r2aiv/motor_driver/IMG-20170615-WA0000.jpg

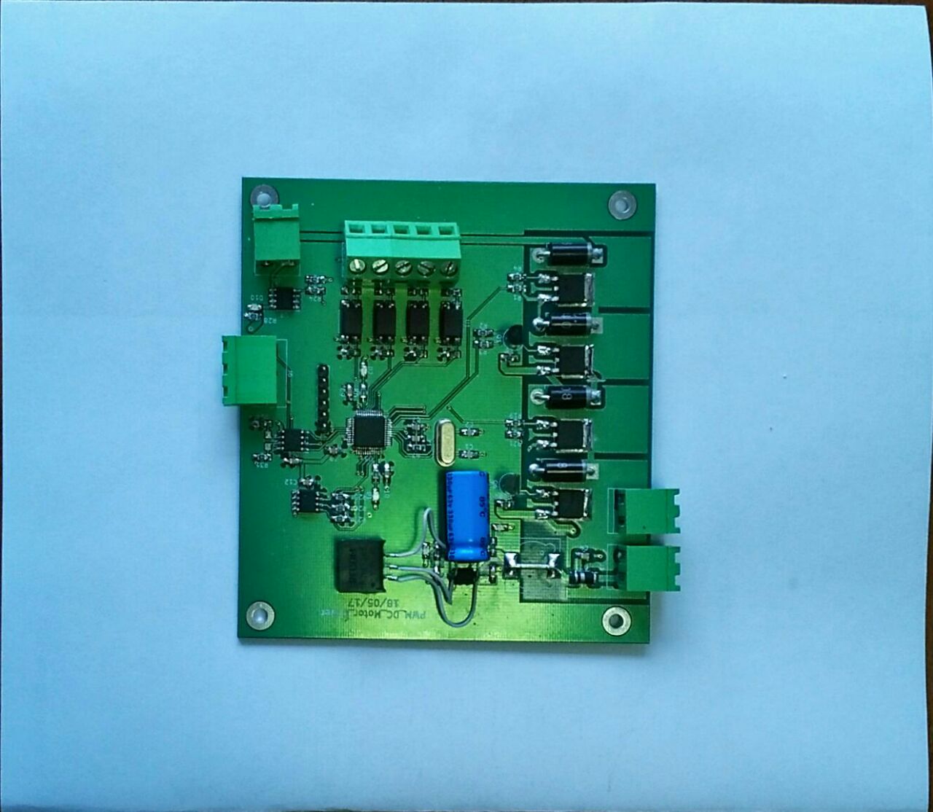
IMG-20170615-WA0000.jpg
