r2aiv/motor_driver/schematic.pdf

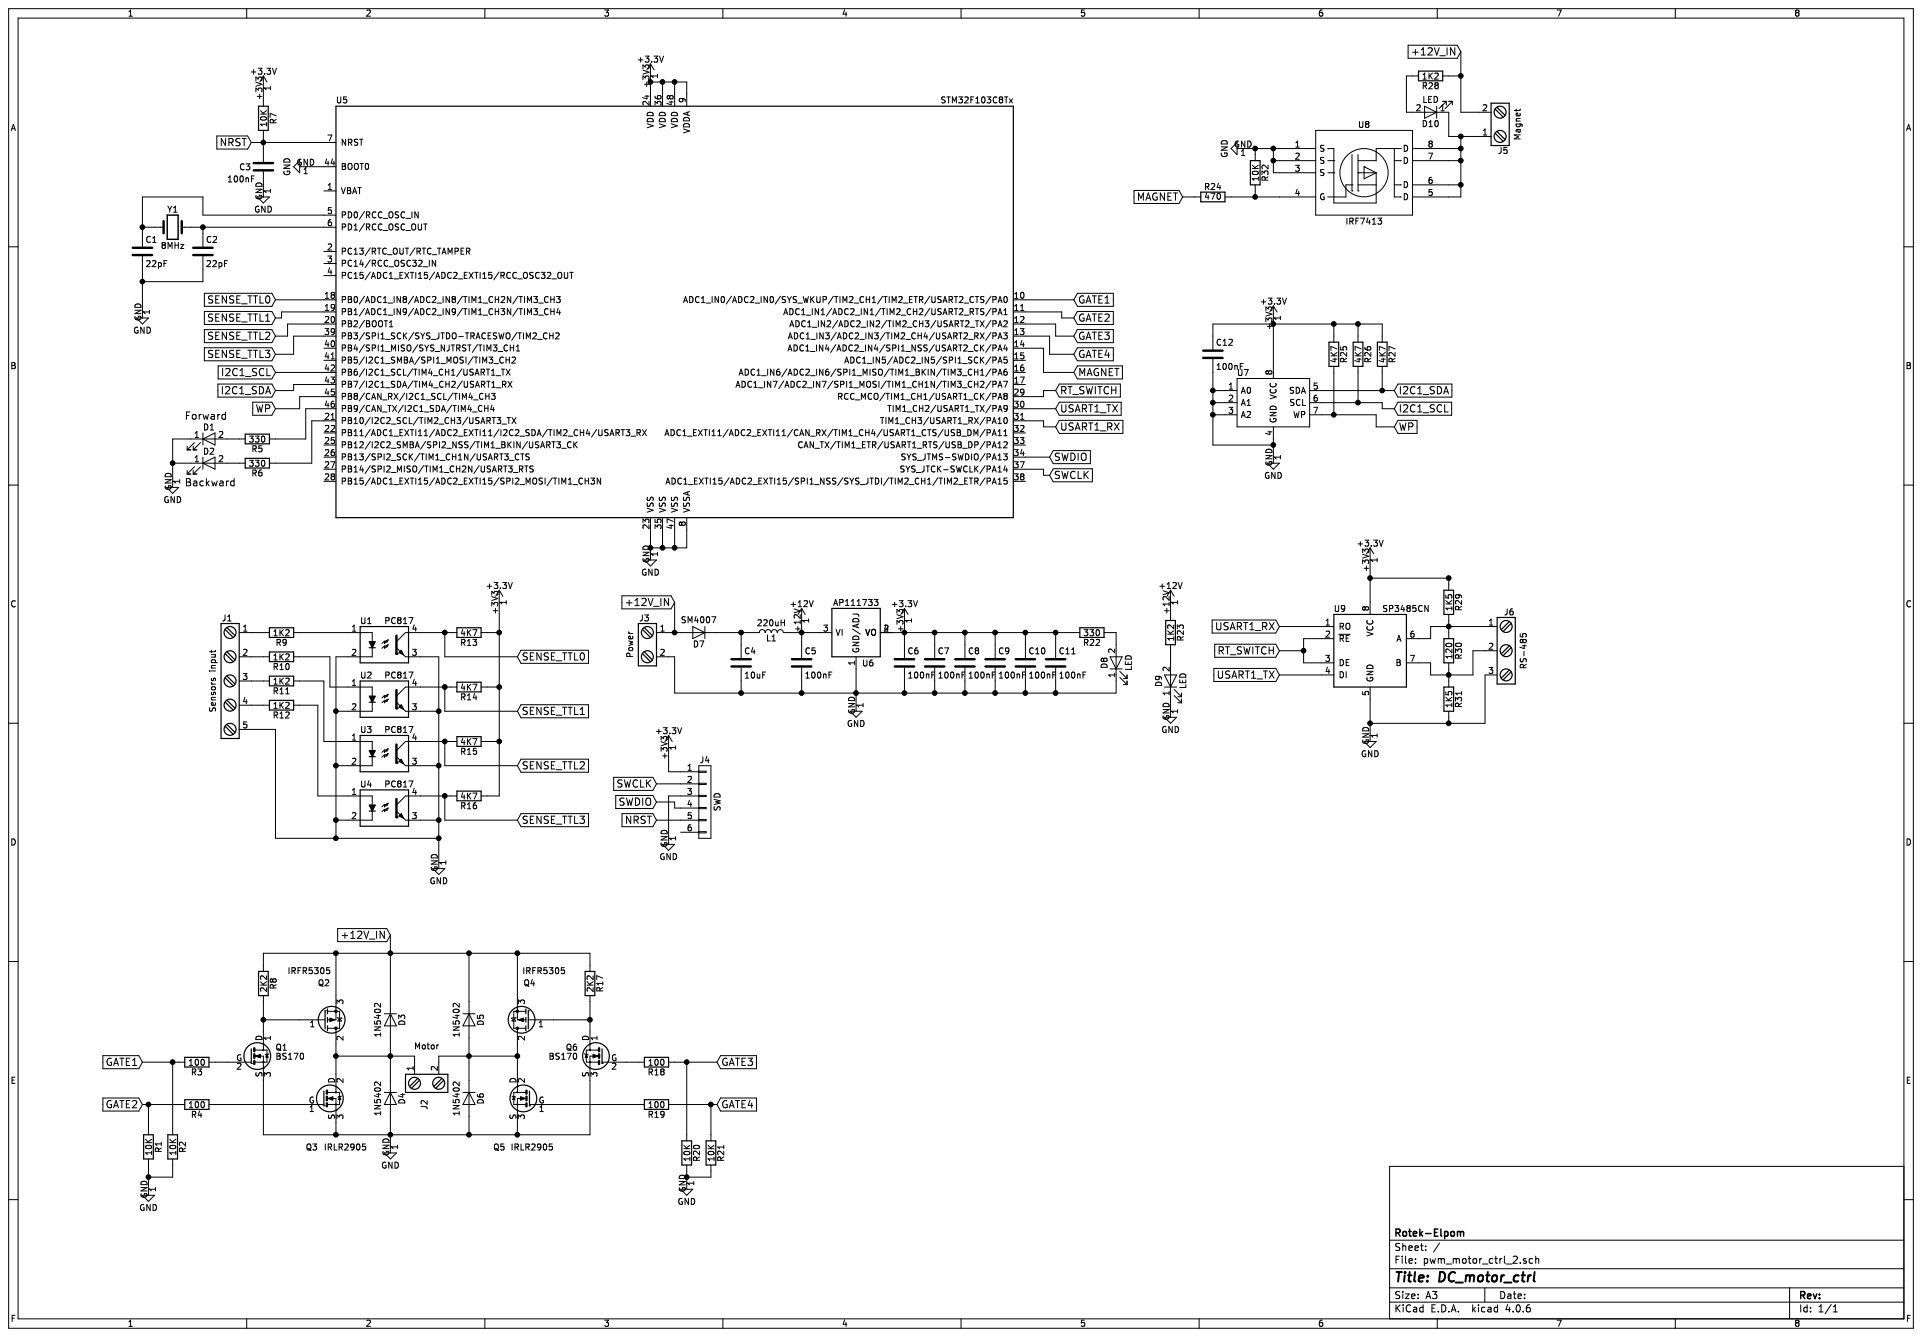
[picture p2: page 1]
