r2aiv/motor_driver/bot.pdf

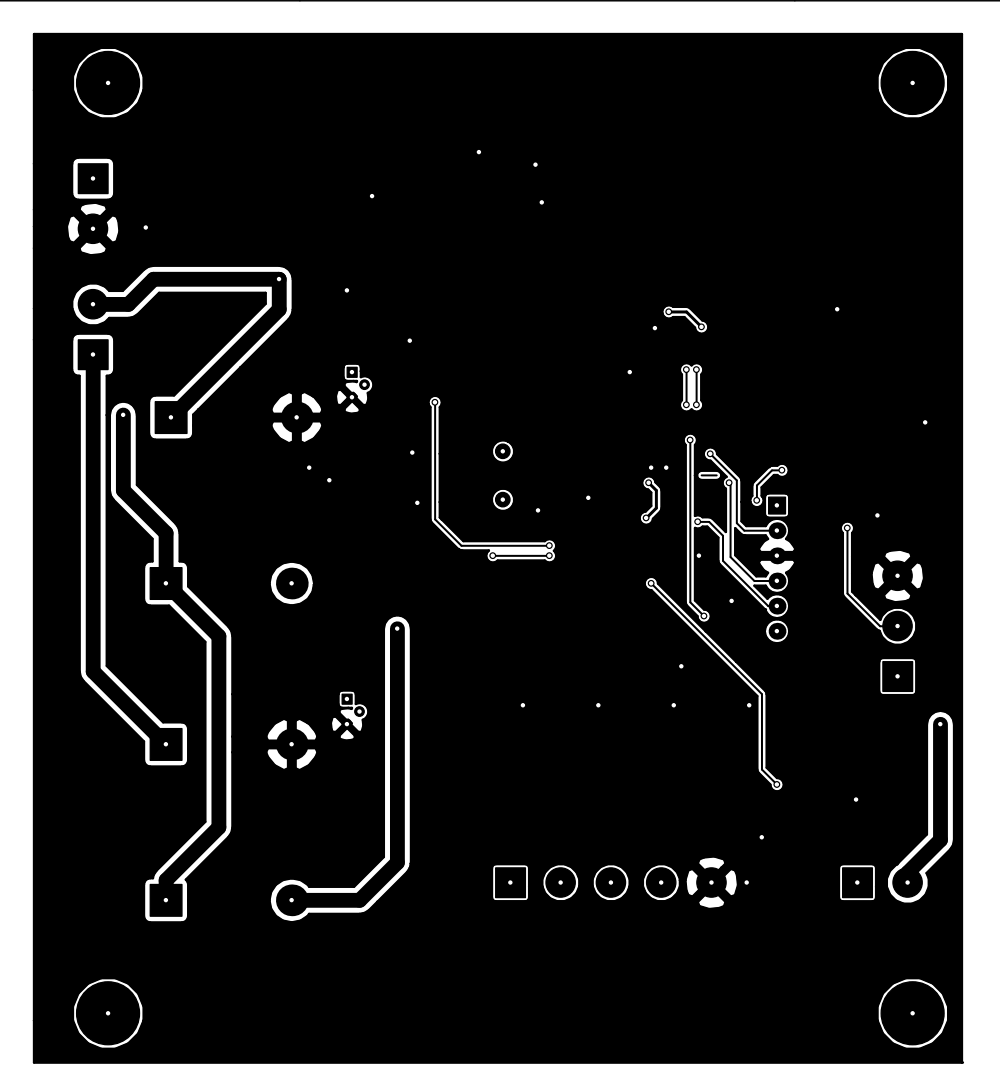
[picture p3: page 1]
