r2aiv/motor_driver/top.pdf

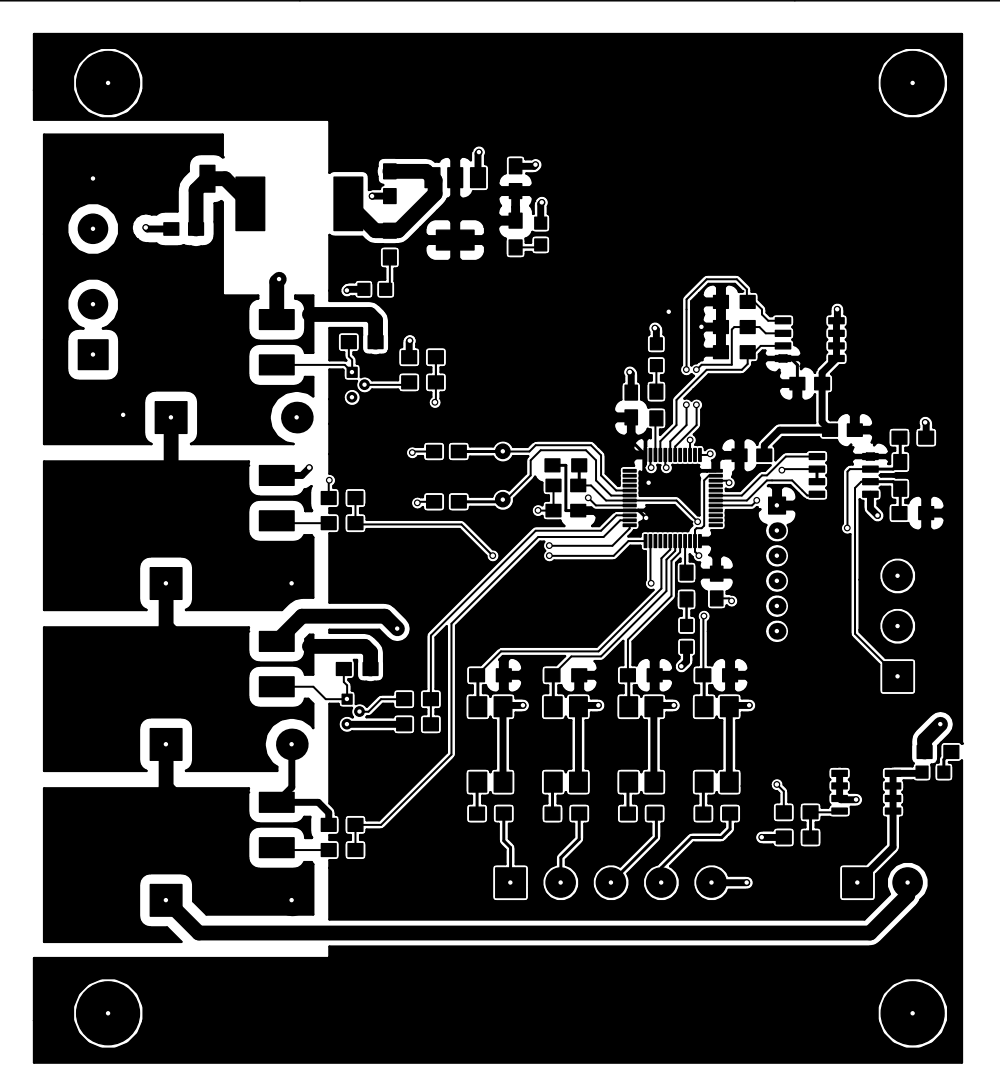
[picture p4: page 1]
