r2aiv/motor_driver/Сборка.pdf

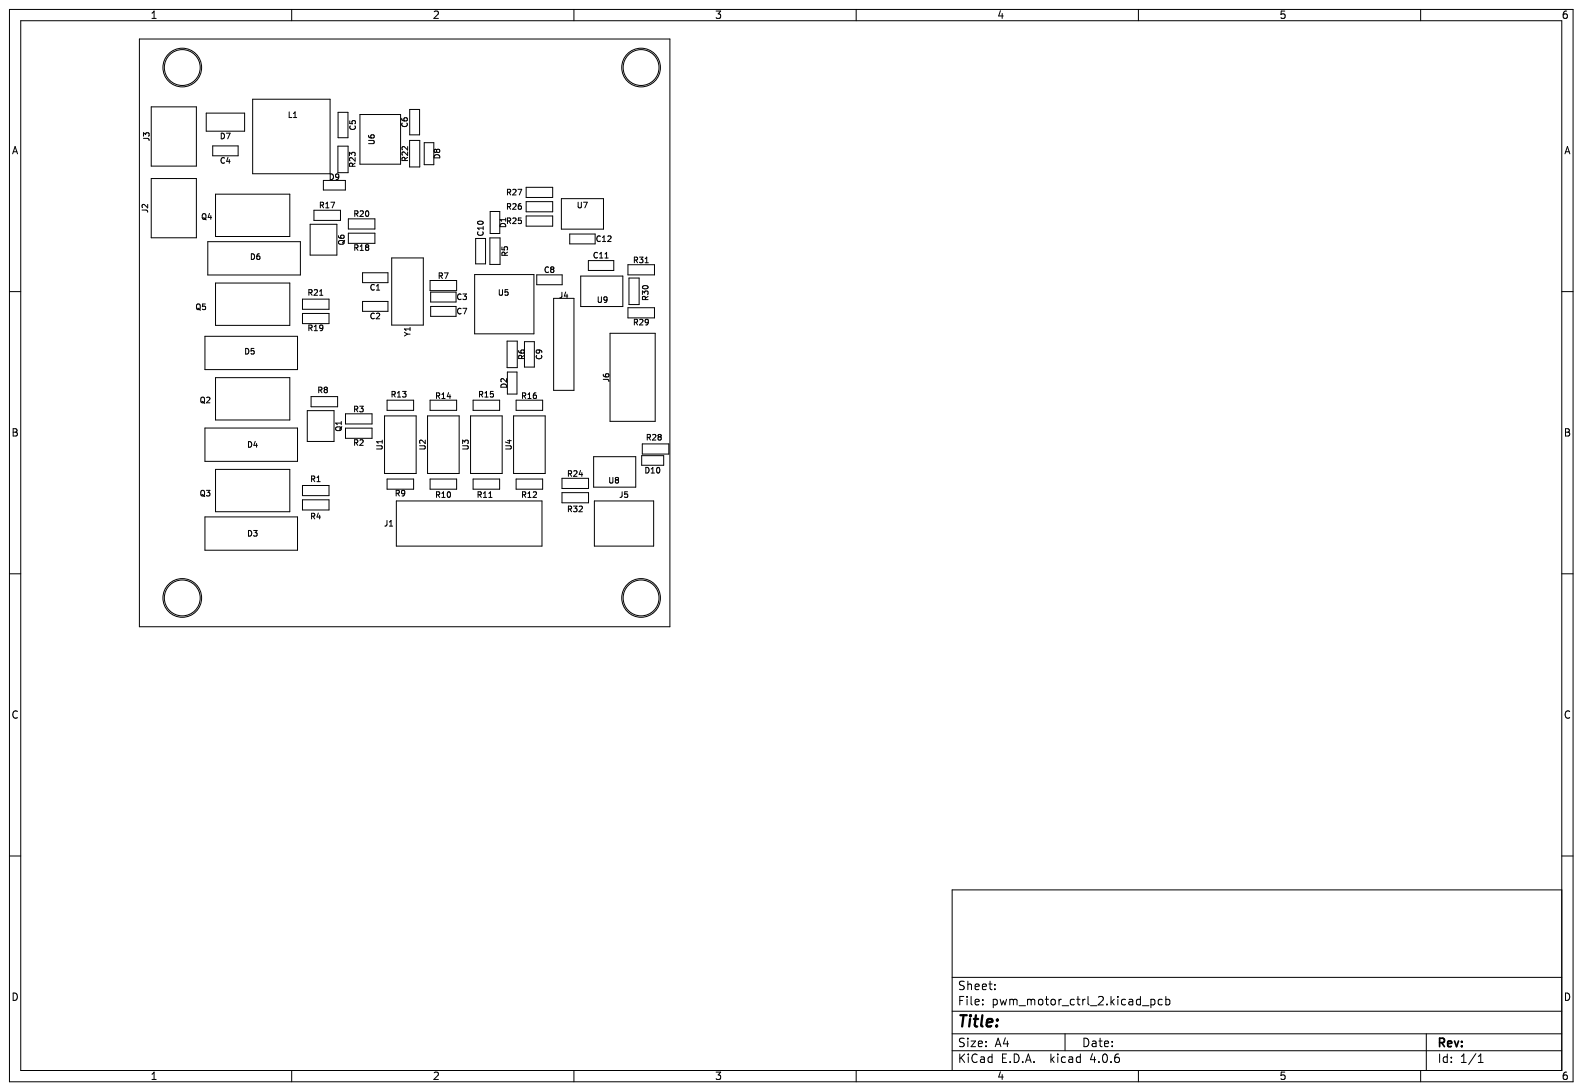
[picture p5: page 1]
