r2aiv/motor_driver/pwm_motor_ctrl_2.kicad_pcb

## KiCad design pwm_motor_ctrl_2.kicad_pcb (2017-08-29)

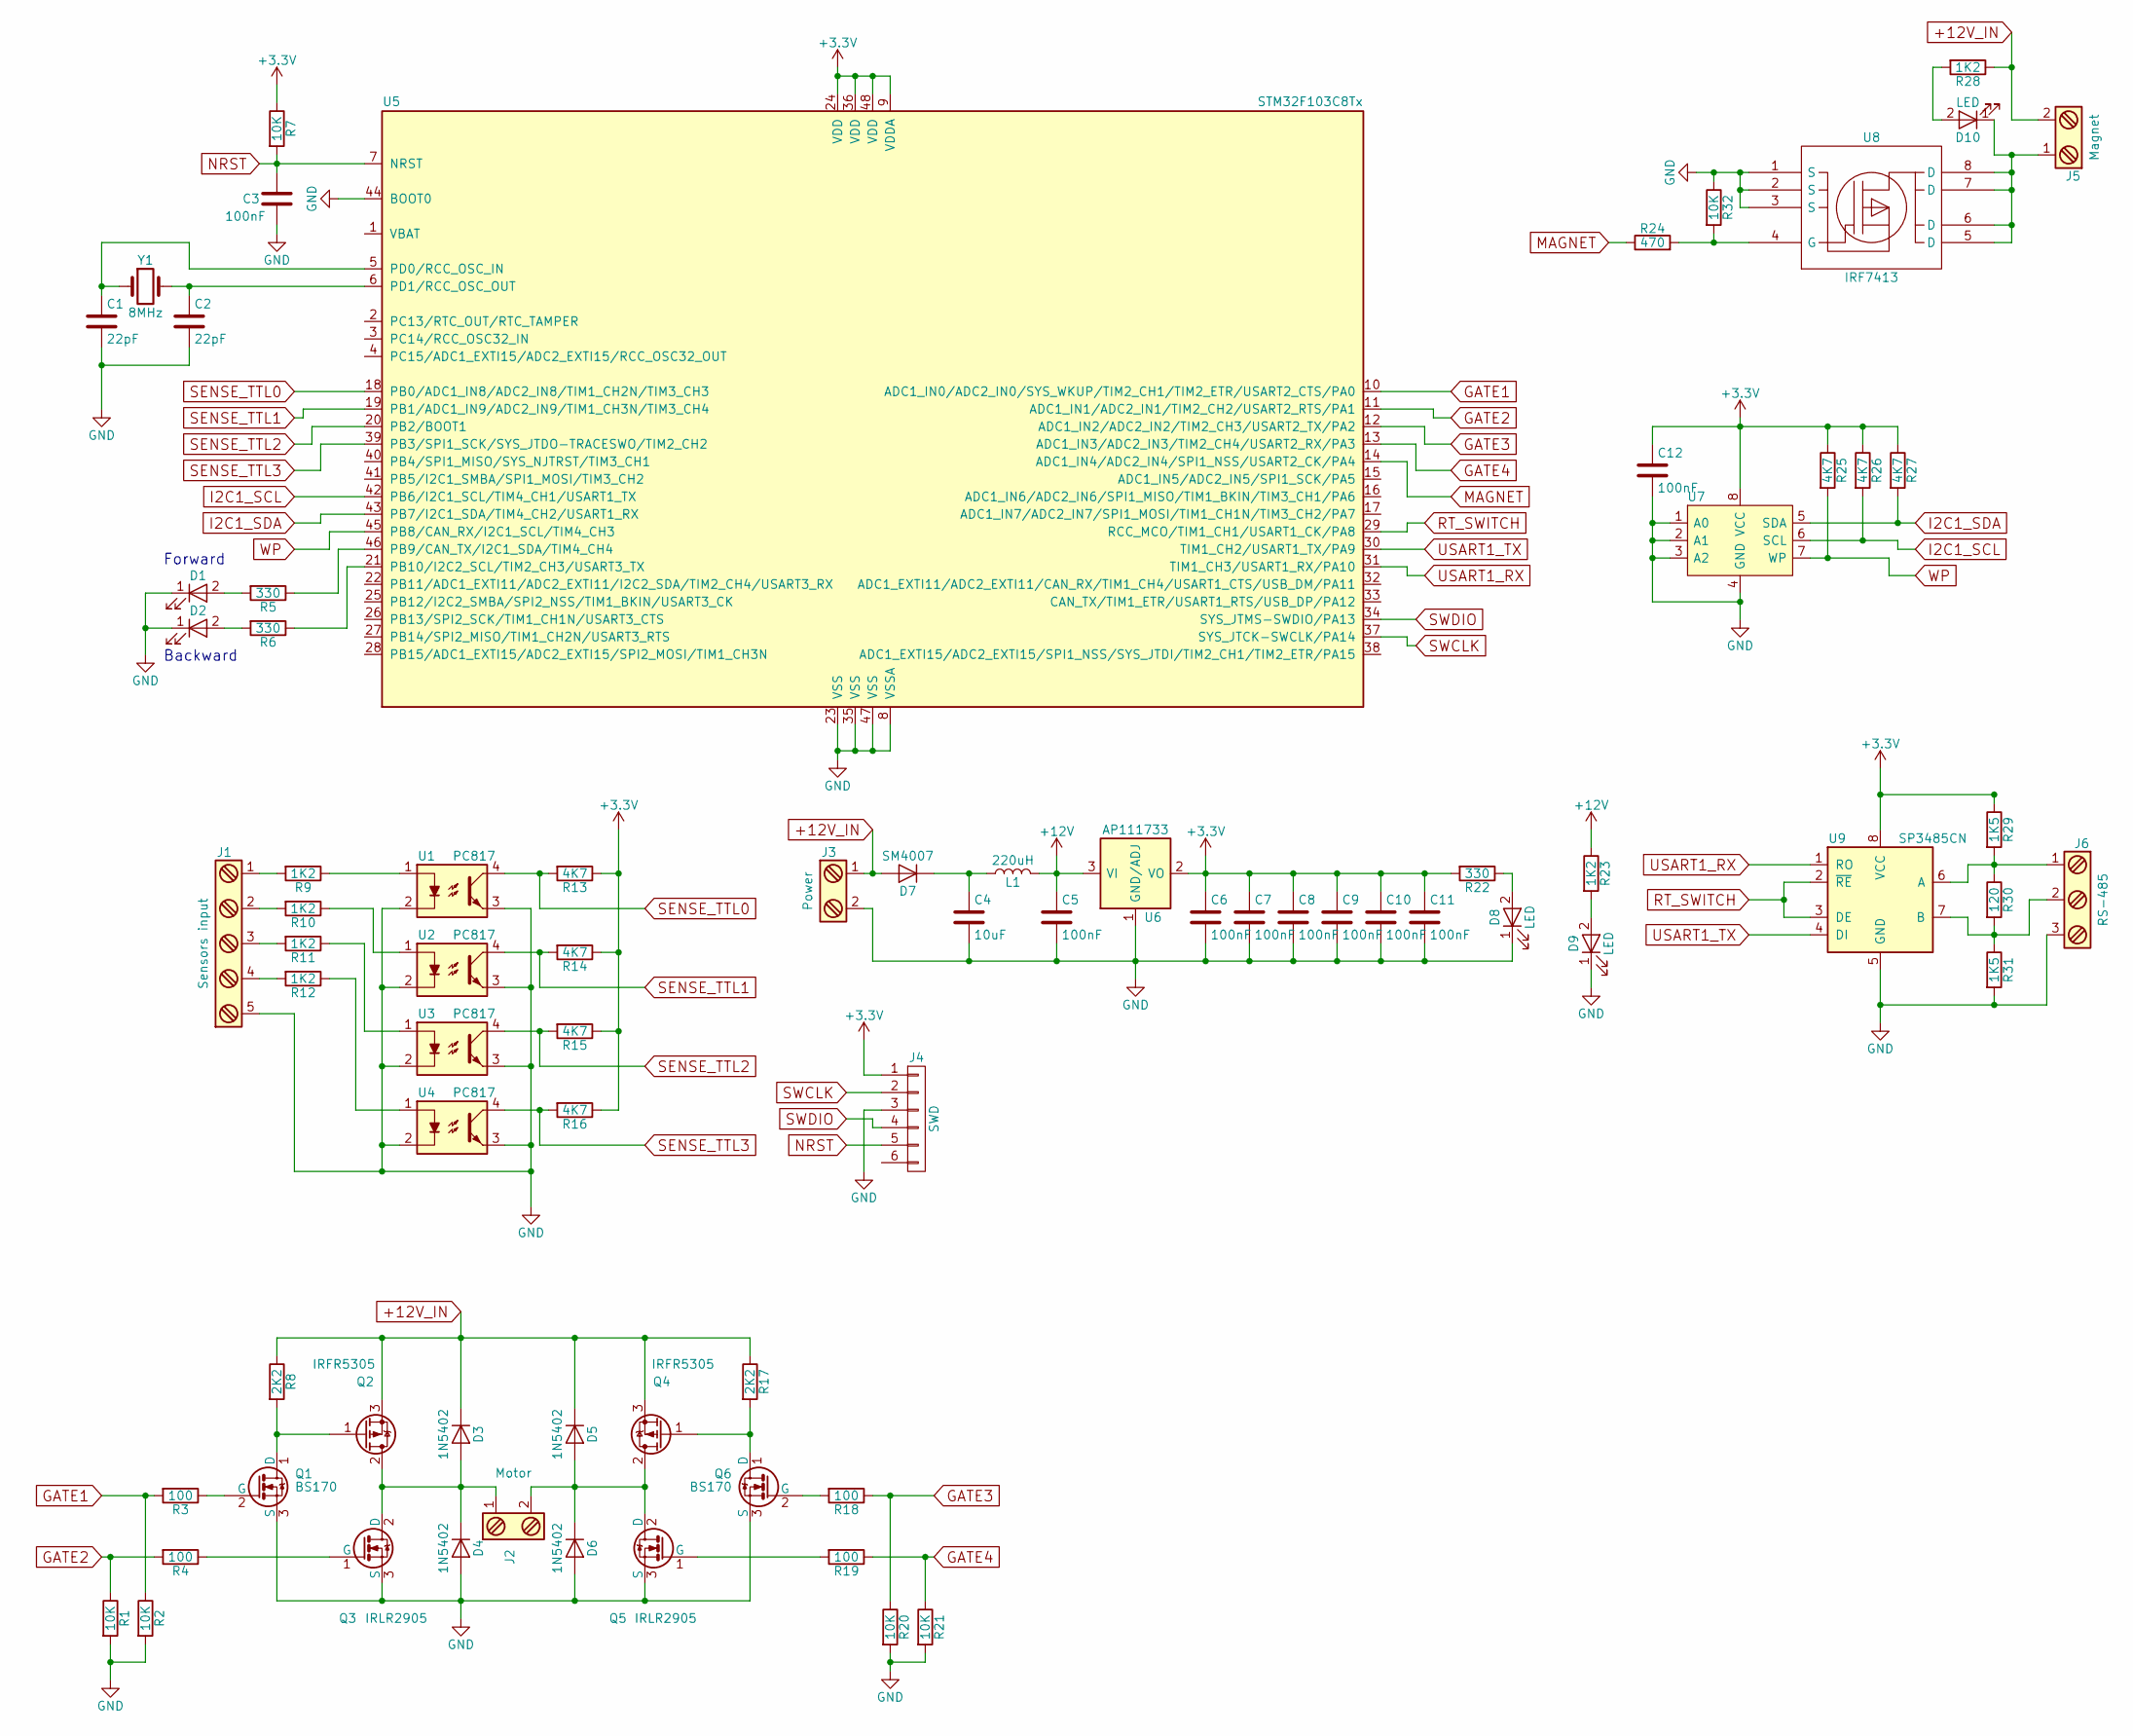
[picture p6: schematic pwm_motor_ctrl_2.sch, DC_motor_ctrl]

Parts:
C1, C2: 22pF; C_0805_HandSoldering
C3, C5, C6, C7, C8, C9, C10, C11, C12: 100nF; C_0805_HandSoldering
C4: 10uF; C_0805_HandSoldering
D1, D2, D8, D9, D10: LED; LED_0805
D3, D4, D5, D6: 1N5402; D_DO-201AD_P12.70mm_Horizontal
D7: SM4007; D_MELF
J1: Sensors input; bornier5
J2: Motor; bornier2
J3: Power; bornier2
J4: SWD; Pin_Header_Straight_1x06_Pitch2.54mm
J5: Magnet; bornier2
J6: RS-485; bornier3
L1: 220uH; Choke_SMD_12x12mm_h6mm
Q1, Q6: BS170; TO-92_Molded_Narrow
Q2, Q4: IRFR5305; TO-252-2_Rectifier
Q3, Q5: IRLR2905; TO-252-2_Rectifier
R1, R2, R7, R20, R21, R32: 10K; R_0805_HandSoldering
R3, R4, R18, R19: 100; R_0805_HandSoldering
R5, R6, R22: 330; R_0805_HandSoldering
R8, R17: 2K2; R_0805_HandSoldering
R9, R10, R11, R12, R23, R28: 1K2; R_0805_HandSoldering
R13, R14, R15, R16, R25, R26, R27: 4K7; R_0805_HandSoldering
R24: 470; R_0805_HandSoldering
R29, R31: 1K5; R_0805_HandSoldering
R30: 120; R_0805_HandSoldering
U1, U2, U3, U4: PC817; DIP-4_W7.62mm_SMD
U5: STM32F103C8Tx; LQFP-48_7x7mm_Pitch0.5mm
U6: AP111733; SOT-223
U7: 24LC02; SOIC-8_3.9x4.9mm_Pitch1.27mm
U8: IRF7413; SOIC-8_3.9x4.9mm_Pitch1.27mm
U9: SP3485CN; SOIC-8_3.9x4.9mm_Pitch1.27mm
Y1: 8MHz; Crystal_HC49-U_Vertical

Connections:
+3V3: C6.1, C7.1, C8.1, C9.1, C10.1, C11.1, C12.1, J4.1, R7.1, R13.1, R14.1, R15.1, R16.1, R22.2, R25.1, R26.1, R27.1, R29.1, U5.9 (VDDA), U5.24 (VDD), U5.36 (VDD), U5.48 (VDD), U6.2 (VO), U6.4 (VO), U7.8 (VCC), U9.8 (VCC)
+12V: C5.1, L1.2, R23.1, U6.3 (VI)
+12V_IN: D3.1 (K), D5.1 (K), D7.2 (A), J3.1, J5.2, Q2.3 (S), Q4.3 (S), R8.1, R17.1, R28.1
GATE1: R2.1, R3.2, U5.10 (ADC1_IN0/ADC2_IN0/SYS_WKUP/TIM2_CH1/TIM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)
GATE2: R1.1, R4.2, U5.11 (ADC1_IN1/ADC2_IN1/TIM2_CH2/USART2_RTS/P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)
GATE3: R18.1, R20.1, U5.12 (ADC1_IN2/ADC2_IN2/TIM2_CH3/USART2_TX/PA2)
GATE4: R19.1, R21.1, U5.13 (ADC1_IN3/ADC2_IN3/TIM2_CH4/USART2_RX/PA3)
GND: C1.2, C2.2, C3.2, C4.2, C5.2, C6.2, C7.2, C8.2, C9.2, C10.2, C11.2, C12.2, D1.1 (K), D2.1 (K), D4.2 (A), D6.2 (A), D8.1 (K), D9.1 (K), J1.5, J3.2, J4.3, J6.3, Q1.3 (S), Q3.3 (S), Q5.3 (S), Q6.3 (S), R1.2, R2.2, R20.2, R21.2, R31.2, R32.1, U1.2, U1.3, U2.2, U2.3, U3.2, U3.3, U4.2, U4.3, U5.8 (VSSA), U5.23 (VSS), U5.35 (VSS), U5.44 (BOOT0), U5.47 (VSS), U6.1 (GND/ADJ), U7.1 (A0), U7.2 (A1), U7.3 (A2), U7.4 (GND), U8.1 (S), U8.2 (S), U8.3 (S), U9.5 (GND)
I2C1_SCL: R26.2, U5.42 (PB6/I2C1_SCL/TIM4_CH1/USART1_TX), U7.6 (SCL)
I2C1_SDA: R27.2, U5.43 (PB7/I2C1_SDA/TIM4_CH2/USART1_RX), U7.5 (SDA)
MAGNET: R24.1, U5.14 (ADC1_IN4/ADC2_IN4/SPI1_NSS/USART2_CK/PA4)
NRST: C3.1, J4.5, R7.2, U5.7 (NRST)
unnamed: C1.1, U5.5 (PD0/RCC_OSC_IN), Y1.1
unnamed: C2.1, U5.6 (PD1/RCC_OSC_OUT), Y1.2
unnamed: C4.1, D7.1 (K), L1.1
unnamed: D1.2 (A), R5.2
unnamed: D2.2 (A), R6.2
unnamed: D3.2 (A), D4.1 (K), J2.1, Q2.2 (D), Q3.2 (D)
unnamed: D5.2 (A), D6.1 (K), J2.2, Q4.2 (D), Q5.2 (D)
unnamed: D8.2 (A), R22.1
unnamed: D9.2 (A), R23.2
unnamed: D10.1 (K), J5.1, U8.5 (D), U8.6 (D), U8.7 (D), U8.8 (D)
unnamed: D10.2 (A), R28.2
unnamed: J1.1, R9.2
unnamed: J1.2, R10.2
unnamed: J1.3, R11.2
unnamed: J1.4, R12.2
unnamed: J6.1, R29.2, R30.1, U9.6 (A)
unnamed: J6.2, R30.2, R31.1, U9.7 (B)
unnamed: Q1.1 (D), Q2.1 (G), R8.2
unnamed: Q1.2 (G), R3.1
unnamed: Q3.1 (G), R4.1
unnamed: Q4.1 (G), Q6.1 (D), R17.2
unnamed: Q5.1 (G), R19.2
unnamed: Q6.2 (G), R18.2
unnamed: R5.1, U5.46 (PB9/CAN_TX/I2C1_SDA/TIM4_CH4)
unnamed: R6.1, U5.21 (PB10/I2C2_SCL/TIM2_CH3/USART3_TX)
unnamed: R9.1, U1.1
unnamed: R10.1, U2.1
unnamed: R11.1, U3.1
unnamed: R12.1, U4.1
unnamed: R24.2, R32.2, U8.4 (G)
RT_SWITCH: U5.29 (RCC_MCO/TIM1_CH1/USART1_CK/PA8), U9.2 (~RE~), U9.3 (DE)
SENSE_TTL0: R13.2, U1.4, U5.18 (PB0/ADC1_IN8/ADC2_IN8/TIM1_CH2N/TIM3_CH3)
SENSE_TTL1: R14.2, U2.4, U5.19 (PB1/ADC1_IN9/ADC2_IN9/TIM1_CH3N/TIM3_CH4)
SENSE_TTL2: R15.2, U3.4, U5.20 (PB2/BOOT1)
SENSE_TTL3: R16.2, U4.4, U5.39 (PB3/SPI1_SCK/SYS_JTDO-TRACESWO/TIM2_CH2)
SWCLK: J4.2, U5.37 (SYS_JTCK-SWCLK/PA14)
SWDIO: J4.4, U5.34 (SYS_JTMS-SWDIO/PA13)
USART1_RX: U5.31 (TIM1_CH3/USART1_RX/PA10), U9.1 (RO)
USART1_TX: U5.30 (TIM1_CH2/USART1_TX/PA9), U9.4 (DI)
WP: R25.2, U5.45 (PB8/CAN_RX/I2C1_SCL/TIM4_CH3), U7.7 (WP)

Notes on the sheet:
Forward
Backward

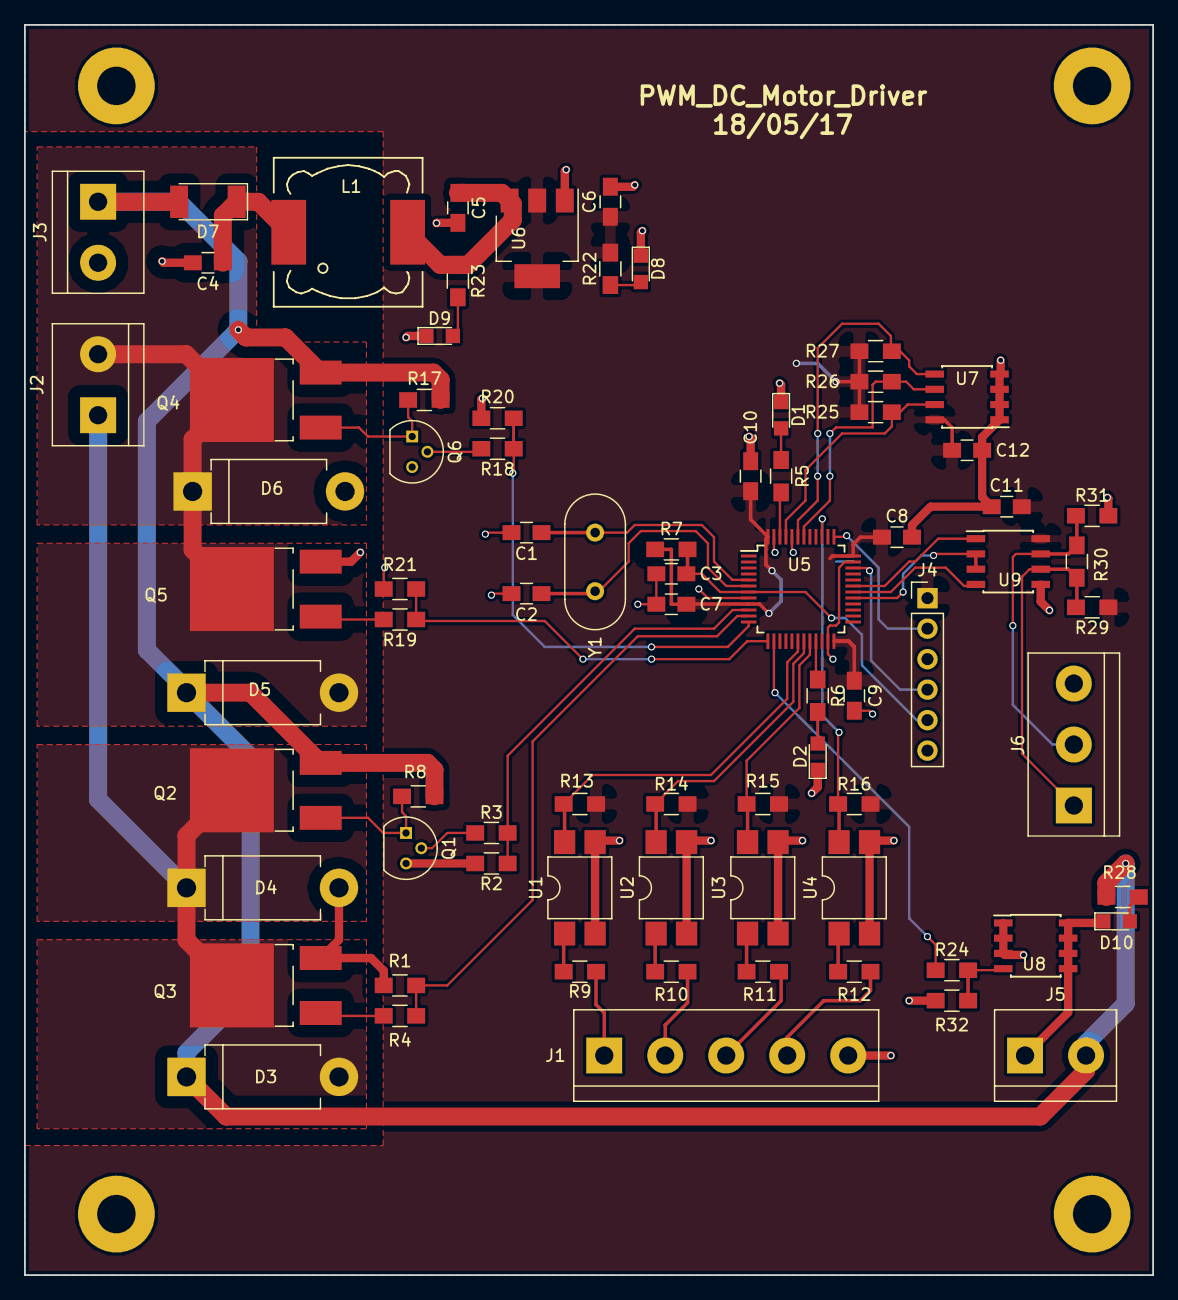
[picture p7: board pwm_motor_ctrl_2.kicad_pcb from above]

Board: 2 copper layers, 94.0 x 104.1 mm, 77 parts (0 on the bottom side), 52 nets.
