r2aiv/motor_driver/Firmware/pwm_motor_ctrl/pwm_motor_ctrl.ioc

Mcu.UserName=STM32F103C8Tx
PA0-WKUP.GPIO_Label=GATE1
PA0-WKUP.Signal=GPIO_Output
PA1.GPIO_Label=GATE2
PA1.Signal=GPIO_Output
PA10.Signal=USART1_RX
PA13.Signal=SYS_JTMS-SWDIO
PA14.Signal=SYS_JTCK-SWCLK
PA2.GPIO_Label=GATE3
PA2.Signal=GPIO_Output
PA3.GPIO_Label=GATE4
PA3.Signal=GPIO_Output
PA4.GPIO_Label=MAGNET
PA4.Signal=GPIO_Output
PA8.GPIO_Label=RT_SWITCH
PA8.Signal=GPIO_Output
PA9.Signal=USART1_TX
PB0.GPIO_Label=SENSE_TTL0
PB0.Signal=GPIO_Input
PB1.GPIO_Label=SENSE_TTL1
PB1.Signal=GPIO_Input
PB10.GPIO_Label=LED2
PB10.Signal=GPIO_Output
PB2.GPIO_Label=SENSE_TTL2
PB2.Signal=GPIO_Input
PB3.GPIO_Label=SENSE_TTL3
PB3.Signal=GPIO_Input
PB6.Signal=I2C1_SCL
PB7.Signal=I2C1_SDA
PB8.GPIO_Label=WP
PB8.Signal=GPIO_Output
PB9.GPIO_Label=LED1
PB9.Signal=GPIO_Output
PD0-OSC_IN.Signal=RCC_OSC_IN
PD1-OSC_OUT.Signal=RCC_OSC_OUT
