r2aiv/motor_driver/Firmware/pwm_motor_ctrl/Src/fet_switch.c

/*

fet_switch.c - Описание функций управления силовыми ключами

*/

#include "main.h"
#include "stm32f1xx_hal.h"
#include "delay.h"

#define STATE_FORWARD 	0x01
#define STATE_BACKWARD 	0x02
#define STATE_HARDSTOP	0x03
#define STATE_STOP 			0x00

extern TIM_HandleTypeDef htim2;
unsigned char DevState;
unsigned char PWMValue;


void FET_Stop(void)						// Останов (снимается напряжение с затворов ключей)
{
	HAL_GPIO_WritePin(GATE1_GPIO_Port,GATE1_Pin,GPIO_PIN_RESET);
	HAL_GPIO_WritePin(GATE2_GPIO_Port,GATE2_Pin,GPIO_PIN_RESET);
	HAL_GPIO_WritePin(GATE3_GPIO_Port,GATE3_Pin,GPIO_PIN_RESET);
	HAL_GPIO_WritePin(GATE4_GPIO_Port,GATE4_Pin,GPIO_PIN_RESET);
	HAL_GPIO_WritePin(LED1_GPIO_Port,LED1_Pin,GPIO_PIN_RESET);
	HAL_GPIO_WritePin(LED2_GPIO_Port,LED2_Pin,GPIO_PIN_RESET);	
}	

void FET_ForwardOn(void)    	// Включает прямое вращение привода
{
	HAL_GPIO_WritePin(GATE1_GPIO_Port,GATE1_Pin,GPIO_PIN_SET);
	HAL_GPIO_WritePin(GATE4_GPIO_Port,GATE4_Pin,GPIO_PIN_SET);
	HAL_GPIO_WritePin(LED1_GPIO_Port,LED1_Pin,GPIO_PIN_SET);
}


void FET_BackwardOn(void)   	// Включает обратное вращение привода
{
	HAL_GPIO_WritePin(GATE2_GPIO_Port,GATE2_Pin,GPIO_PIN_SET);
	HAL_GPIO_WritePin(GATE3_GPIO_Port,GATE3_Pin,GPIO_PIN_SET);	
	HAL_GPIO_WritePin(LED2_GPIO_Port,LED2_Pin,GPIO_PIN_SET);
}

void FET_HardStop(void)			// Жесткий останов (открываются ключи Q3 и Q5, обмотки закорачиваются)
{
	FET_Stop();
	HAL_GPIO_WritePin(GATE2_GPIO_Port,GATE2_Pin,GPIO_PIN_SET);
	HAL_GPIO_WritePin(GATE4_GPIO_Port,GATE4_Pin,GPIO_PIN_SET);
}

void FET_ForwardPWM(unsigned char pwm)		// Включение двигателя с определенной скважностью ШИМ pwm - заполнение в процентах
{
			
}

void FET_BackwardPWM(unsigned char pwm)	  // Обратное вращение по ШИМ
{
	
}

void MagnetOn(void) 					// Включение магнита
{
	HAL_GPIO_WritePin(MAGNET_GPIO_Port,MAGNET_Pin,GPIO_PIN_SET);
}

void MagnetOff(void) 				// Выключение магнита
{
	HAL_GPIO_WritePin(MAGNET_GPIO_Port,MAGNET_Pin,GPIO_PIN_RESET);
}

void FET_SoftStart(void)			// Плавный пуск. 
{
	for(int pwm=1;pwm<=100;pwm++)
	{
		switch(DevState)
		{
			case STATE_FORWARD:
				FET_ForwardOn();
				delay_us(pwm*100);
				FET_Stop();
			  delay_us(10000-pwm*100);
				break;
			case STATE_BACKWARD:
				FET_BackwardOn();
				delay_us(pwm*100);
				FET_Stop();
			  delay_us(10000-pwm*100);
				break;
			default:
				FET_Stop();
			break;
			
		}		
	}
}
void FET_SoftStop(void)			// Плавный останов. 
{
	for(int pwm=1;pwm<=100;pwm++)
	{
		switch(DevState)
		{
			case STATE_FORWARD:
				FET_ForwardOn();
				delay_us(10000-pwm*100);
				FET_Stop();
			  delay_us(pwm*100);
				break;
			case STATE_BACKWARD:
				FET_BackwardOn();
				delay_us(10000-pwm*100);
				FET_Stop();
			  delay_us(pwm*100);
				break;
			default:
				FET_Stop();
			break;
			
		}		
	}
}
