r2aiv/motor_driver/(notices)

Notices in the files:
Firmware/pwm_motor_ctrl/Src/main.c:
(C) COPYRIGHT STMicroelectronics *****END OF FILE
